YHC-A/AutoCar/report/closure/photos/prototype-back-redar-low.jpg

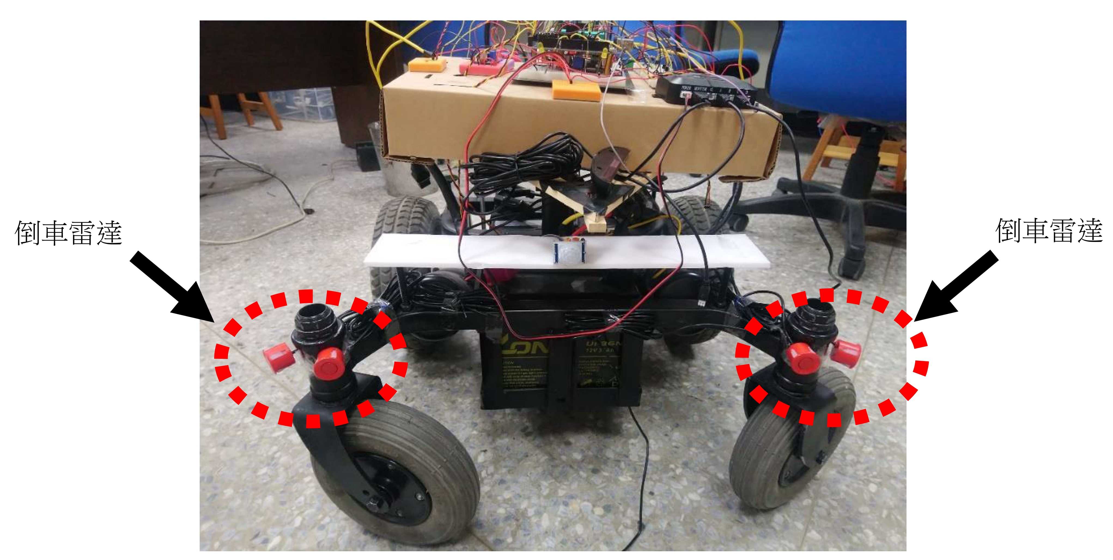
report/closure/photos/prototype-back-redar-low.jpg
