YHC-A/AutoCar/report/closure/廠商同意結案用印.jpg

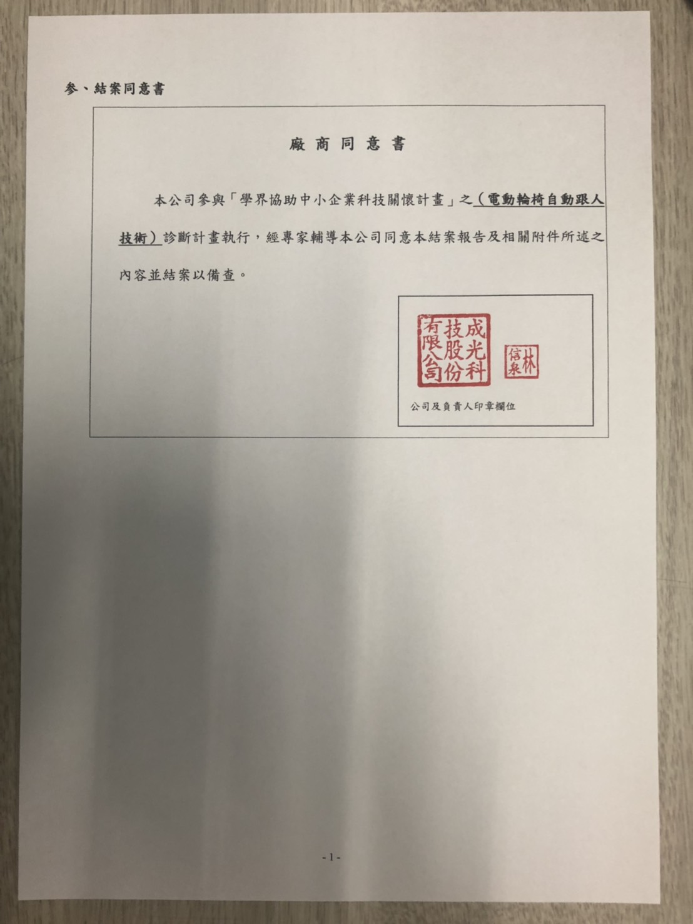
report/closure/廠商同意結案用印.jpg
