YHC-A/AutoCar/report/closure/專家簽收領據單-丁慶華.docx

專家簽收領據單

日期：107年10月8日
項次 | 計畫名稱 | 專家姓名 | 系所 | 計畫期程 | 計畫類型 | 計畫費用(千元)
1 | 電動輪椅自動跟人技術開發 | 機械與能源工程學系 | 丁慶華 | 107年05月~107年10月 | 個案計畫 | 72

專家簽名：
