YHC-A/AutoCar/report/自走車圖片/自走車圖片.docx

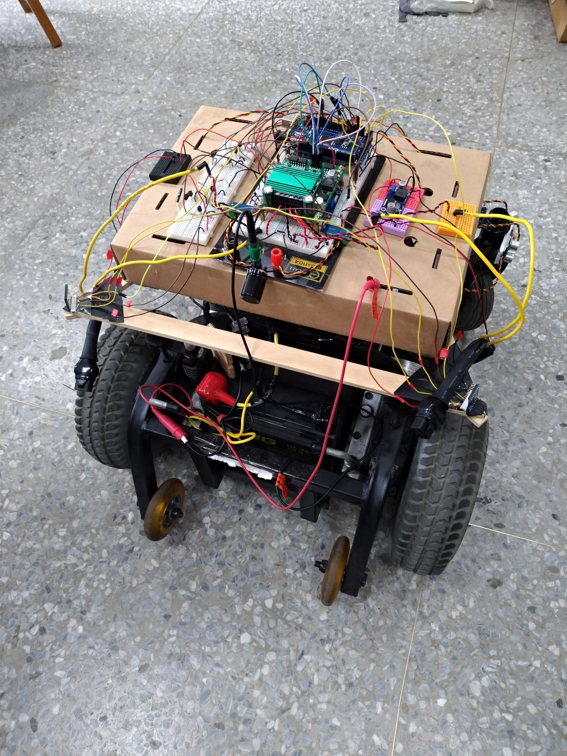
[picture p17: figure]
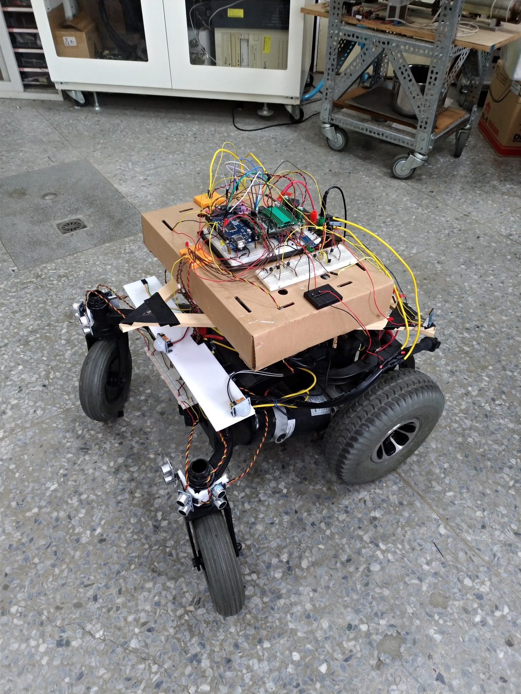
[picture p18: figure]
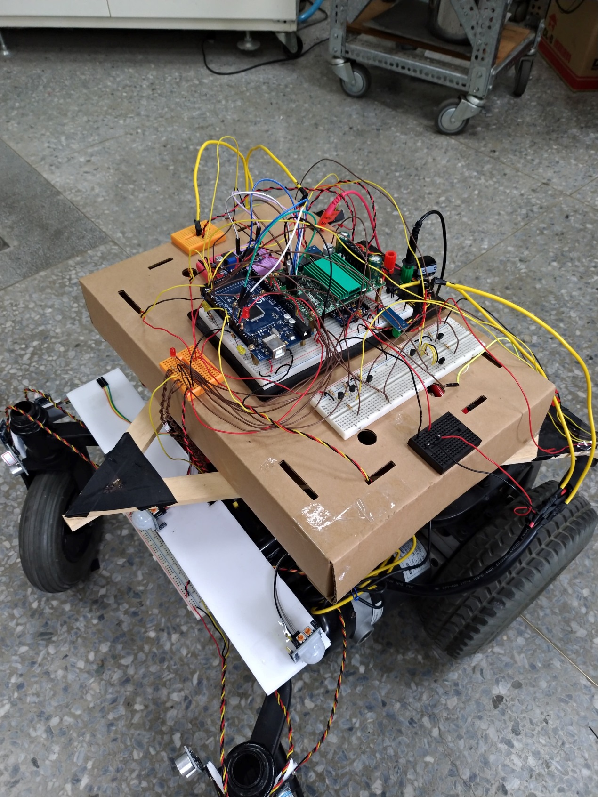
[picture p19: figure]
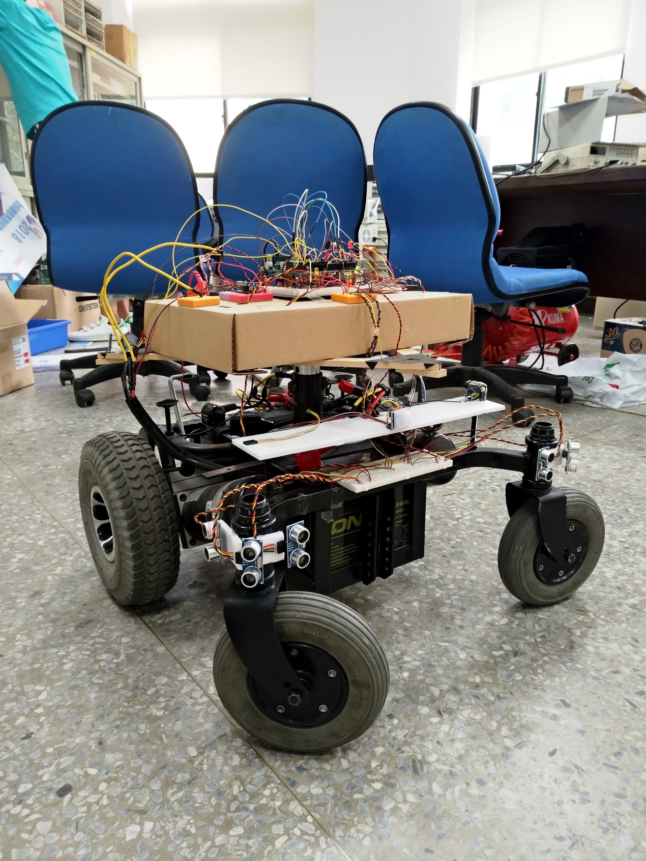
[picture p20: figure]
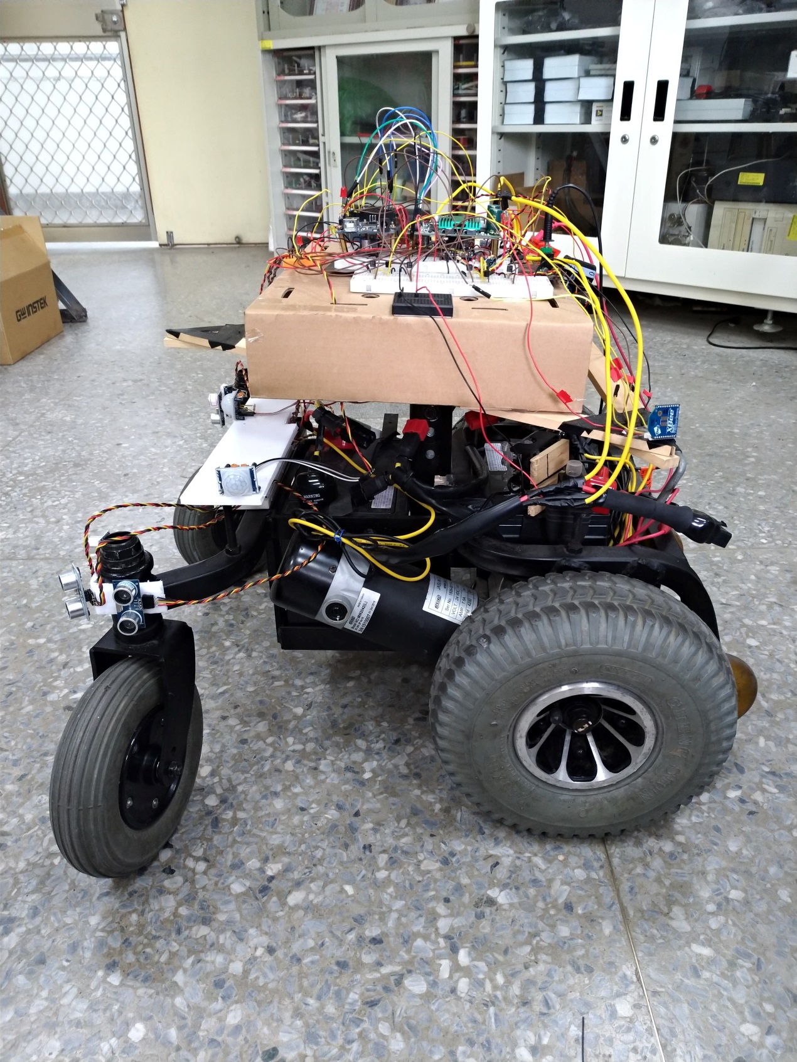
[picture p21: figure]
