YHC-A/AutoCar/report/closure/annoucement/繳交資料檢核表及經費累計表(範例).xlsx

Sheet: 繳交資料檢核表
學界關懷計畫學校繳交資料明細檢核
學校名稱：
項次 | 項目 | 已齊備打v
1 | 結案報告
2 | 經費累計表
3 | 專家簽收領據
4 | 原始支出憑證 (私立學校須寄回）
製表人：
覆 核：

Sheet: 經費累計表-空白
學界協助中小企業科技關懷跨域整合計畫
經費累計表
學校名稱：
計畫名稱：
 |  |  |  |  |  |  | 單位：新台幣元
預算數 |  |  | 累計實支數 ( D ) | 預算餘額 ( E=C-D ) | 累計已撥金額 ( F ) | 應繳回款項 | 備註
全年度預算數 ( A ) | 預算調整項目 ( B ) | 全年度預算數 ( C=A+B )
 |  | 0 |  | 0 |  | 0
製表人： |  | 覆核： |  | 主計主管： |  |  | 機關長官：
註1：預算調整項目係若有撤案等與原始預算金額有變之項目請填此處，並於備註欄位說明

Sheet: 經費累計表-例
學界協助中小企業科技關懷跨域整合計畫
經費累計表
學校名稱： | 漂亮實用大學
計畫名稱： | 咕咕鐘自動化控制技術與創新加值
 |  |  |  |  |  |  | 單位：新台幣元
預算數 |  |  | 累計實支數 ( D ) | 預算餘額 ( E=C-D ) | 累計已撥金額 ( F ) | 應繳回款項 | 備註
全年度預算數 ( A ) | 預算調整項目 ( B ) | 全年度預算數 ( C=A+B )
1272000 |  | 1272000 | 1272000 | 0 | 1272000 | 0
製表人：王大富 |  | 覆核：許大貴 |  | 主計主管： | 陳大滿 |  | 機關長官：林大堂
註1：預算調整項目係若有撤案等與原始預算金額有變之項目請填此處，並於備註欄位說明

Sheet: 經費累計表-例(有撤案)
學界協助中小企業科技關懷跨域整合計畫
經費累計表
學校名稱： | 漂亮實用大學
計畫名稱： | 咕咕鐘自動化控制技術與創新加值
 |  |  |  |  |  |  | 單位：新台幣元
預算數 |  |  | 累計實支數 ( D ) | 預算餘額 ( E=C-D ) | 累計已撥金額 ( F ) | 應繳回款項 | 備註
全年度預算數 ( A ) | 預算調整項目 ( B ) | 全年度預算數 ( C=A+B )
1272000 | -72000 | 1200000 | 1200000 | 0 | 1272000 | 72000 | 撤1個案
製表人：王大富 |  | 覆核：許大貴 |  | 主計主管： | 陳大滿 |  | 機關長官：林大堂
註1：預算調整項目係若有撤案等與原始預算金額有變之項目請填此處，並於備註欄位說明

Sheet: 經費累計表-(預算未支完)
學界協助中小企業科技關懷跨域整合計畫
經費累計表
學校名稱： | 漂亮實用大學
計畫名稱： | 咕咕鐘自動化控制技術與創新加值
 |  |  |  |  |  |  | 單位：新台幣元
預算數 |  |  | 累計實支數 ( D ) | 預算餘額 ( E=C-D ) | 累計已撥金額 ( F ) | 應繳回款項 | 備註
全年度預算數 ( A ) | 預算調整項目 ( B ) | 全年度預算數 ( C=A+B )
1272000 |  | 1272000 | 1100000 | 172000 | 1272000 | 172000
製表人：王大富 |  | 覆核：許大貴 |  | 主計主管： | 陳大滿 |  | 機關長官：林大堂
註1：預算調整項目係若有撤案等與原始預算金額有變之項目請填此處，並於備註欄位說明
