YHC-A/AutoCar/report/2018-08-17-S__95945035.jpg

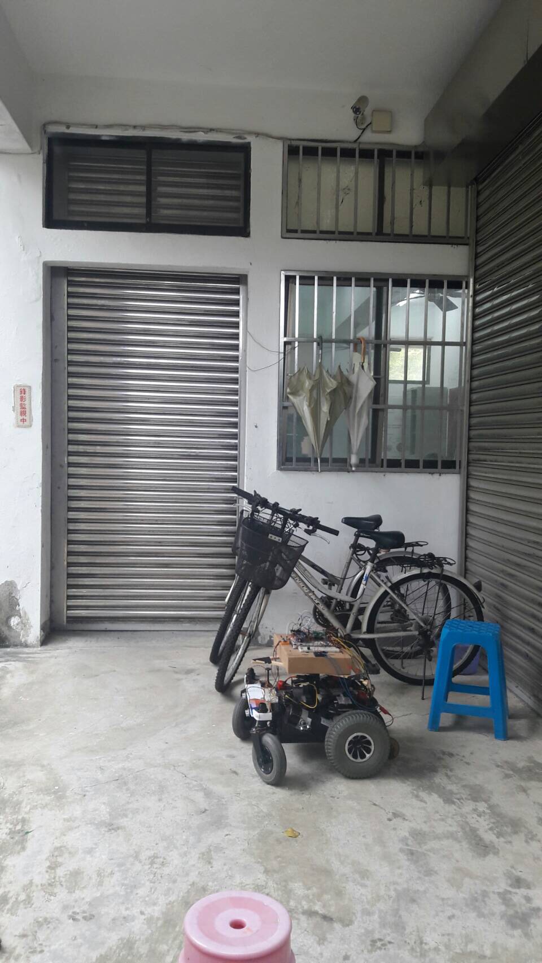
report/2018-08-17-S__95945035.jpg
