YHC-A/AutoCar/report/closure/photos/flow-chart.jpg

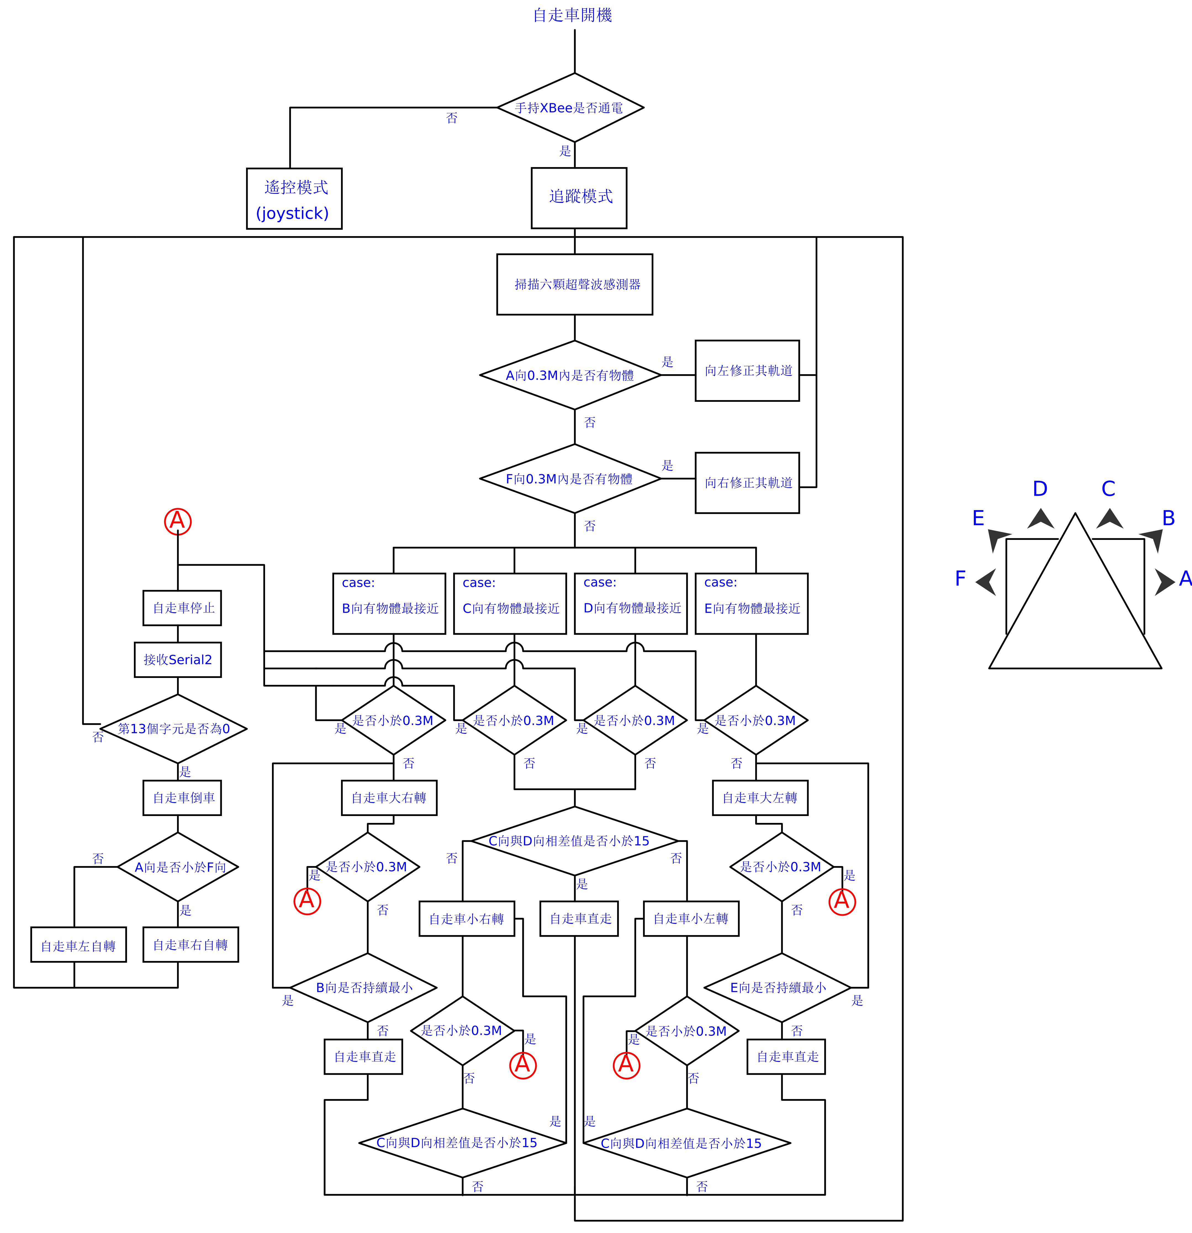
report/closure/photos/flow-chart.jpg
