YHC-A/AutoCar/report/closure/photos/system-architecture.jpg

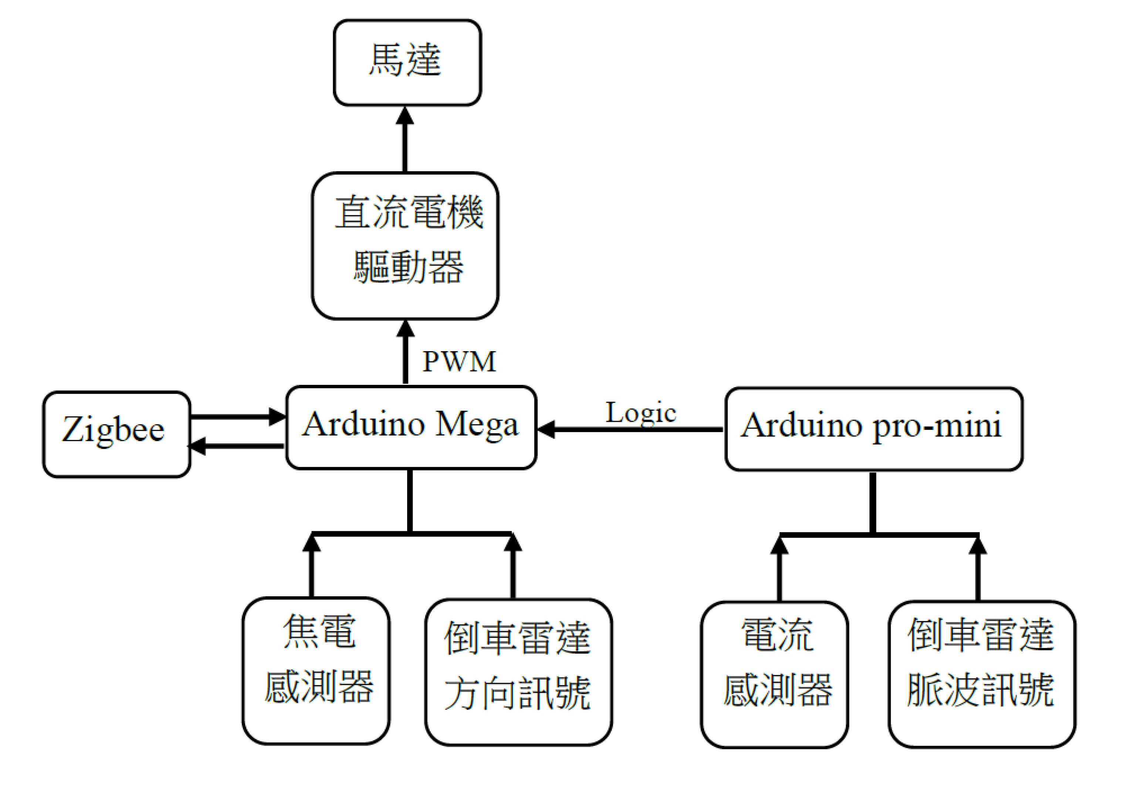
report/closure/photos/system-architecture.jpg
