YHC-A/AutoCar/report/控制器切換電路/繼電器切換.png

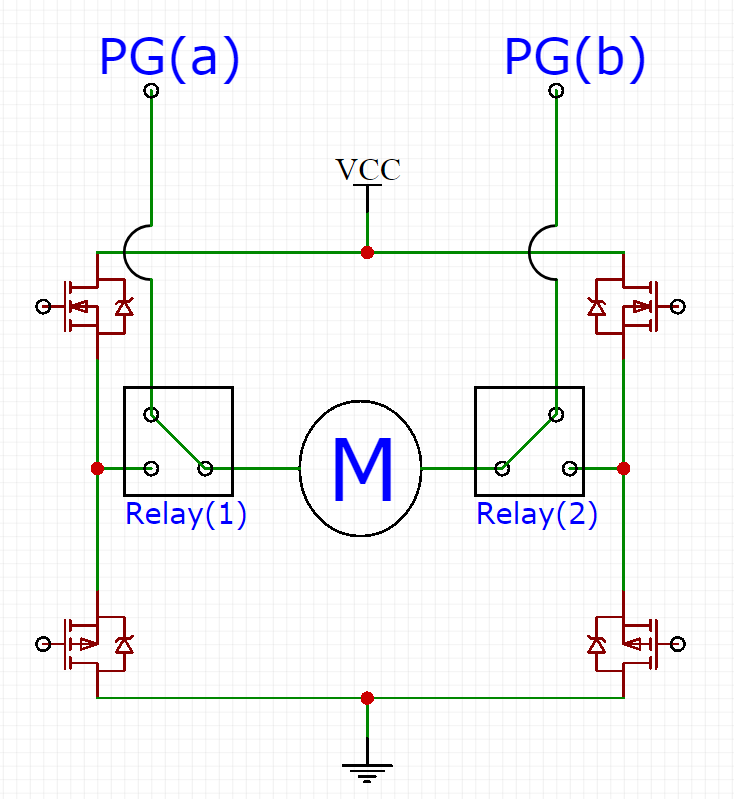
report/控制器切換電路/繼電器切換.png
