YHC-A/AutoCar/report/黃思豪/硬體線路.jpg

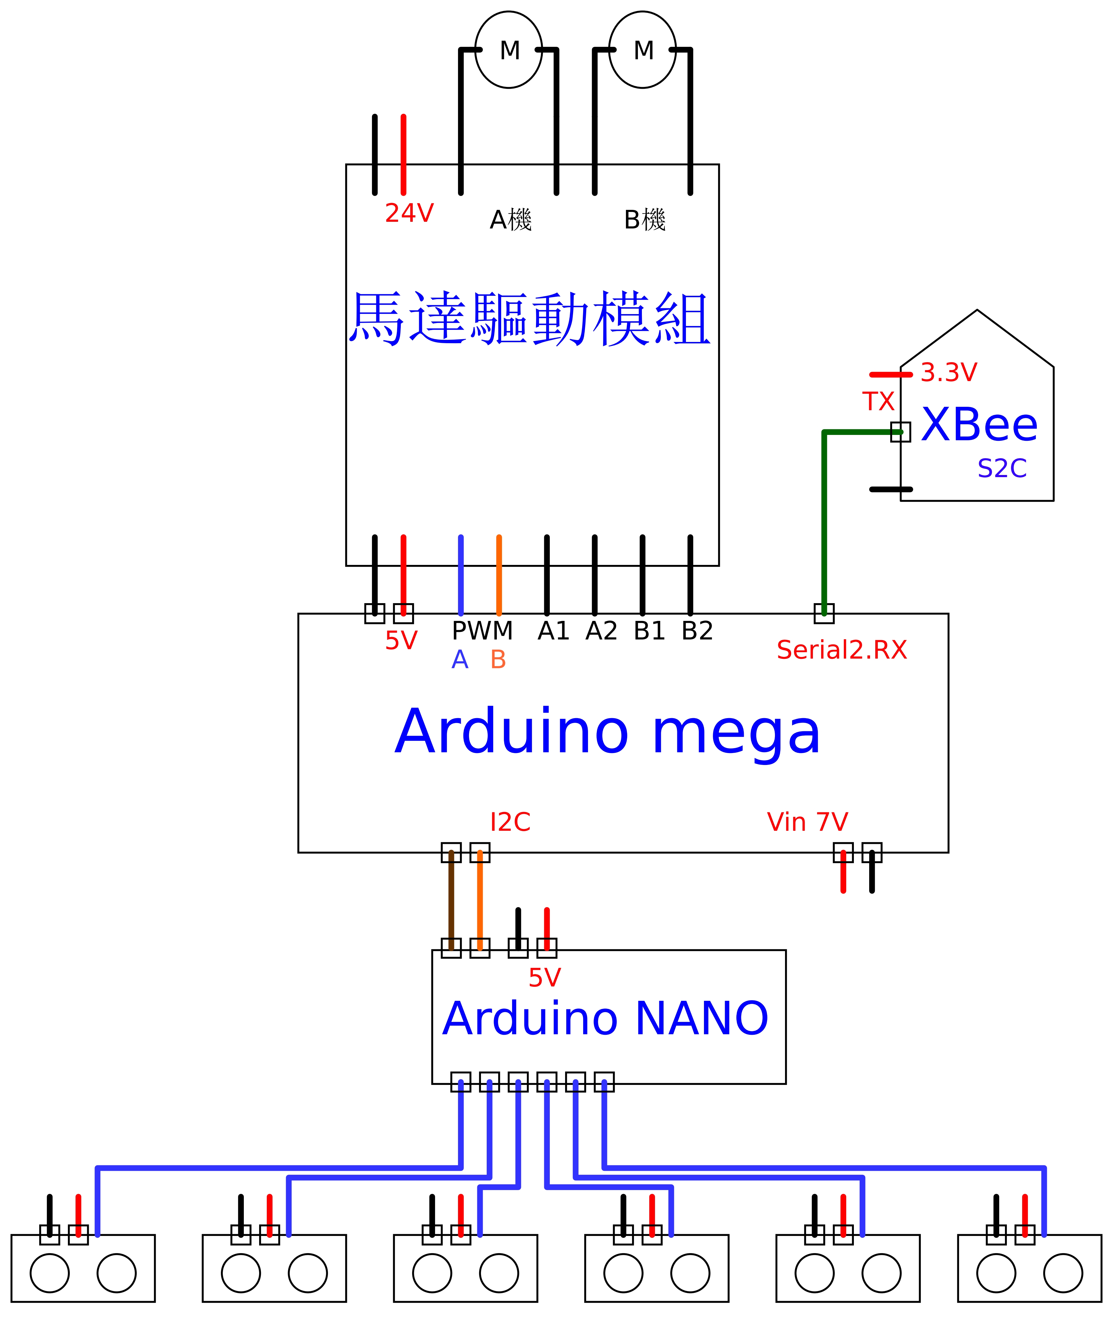
report/黃思豪/硬體線路.jpg
