YHC-A/AutoCar/report/黃思豪/紅外線.bmp

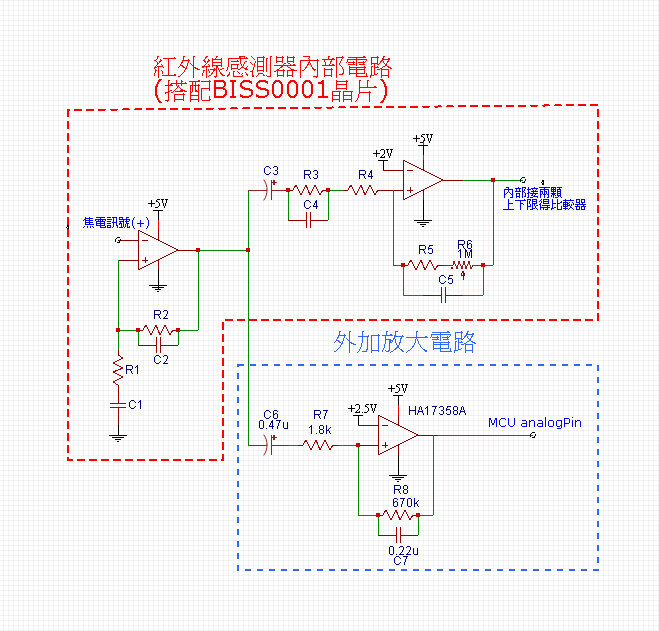
report/黃思豪/紅外線.bmp
