YHC-A/AutoCar/report/黃思豪/繼電器.bmp

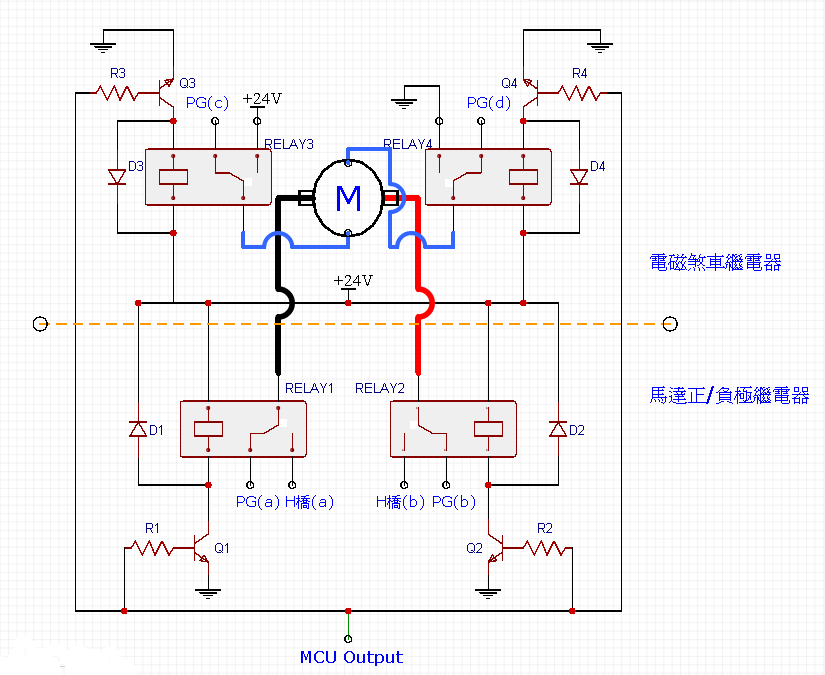
report/黃思豪/繼電器.bmp
