YHC-A/AutoCar/2018-01-成光-Zigbee追蹤/purchase/ID-back.jpg

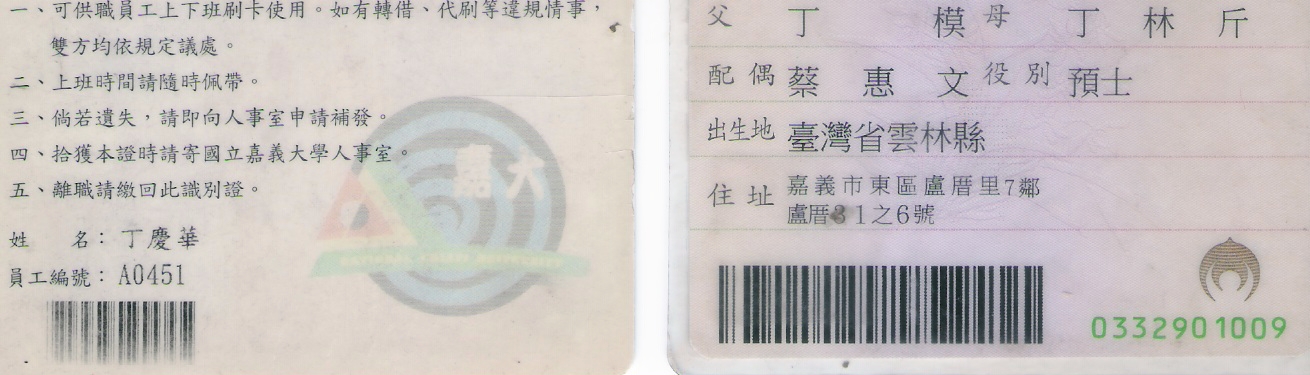
2018-01-成光-Zigbee追蹤/purchase/ID-back.jpg
