YHC-A/AutoCar/2018-01-成光-Zigbee追蹤/purchase/ID-front.jpg

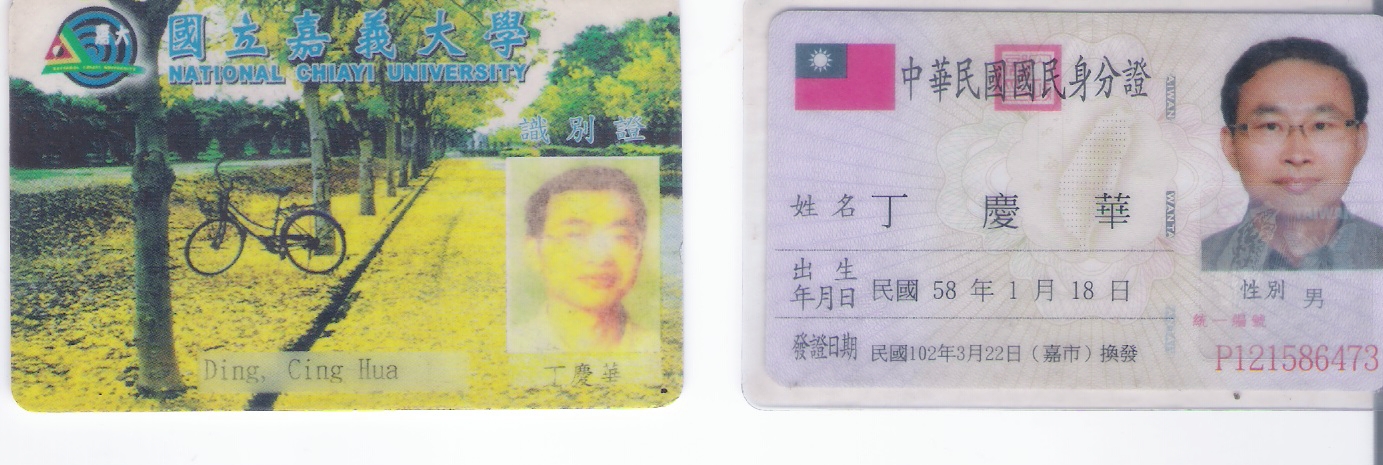
2018-01-成光-Zigbee追蹤/purchase/ID-front.jpg
