YHC-A/AutoCar/2018-01-成光-Zigbee追蹤/purchase/委任書.jpg

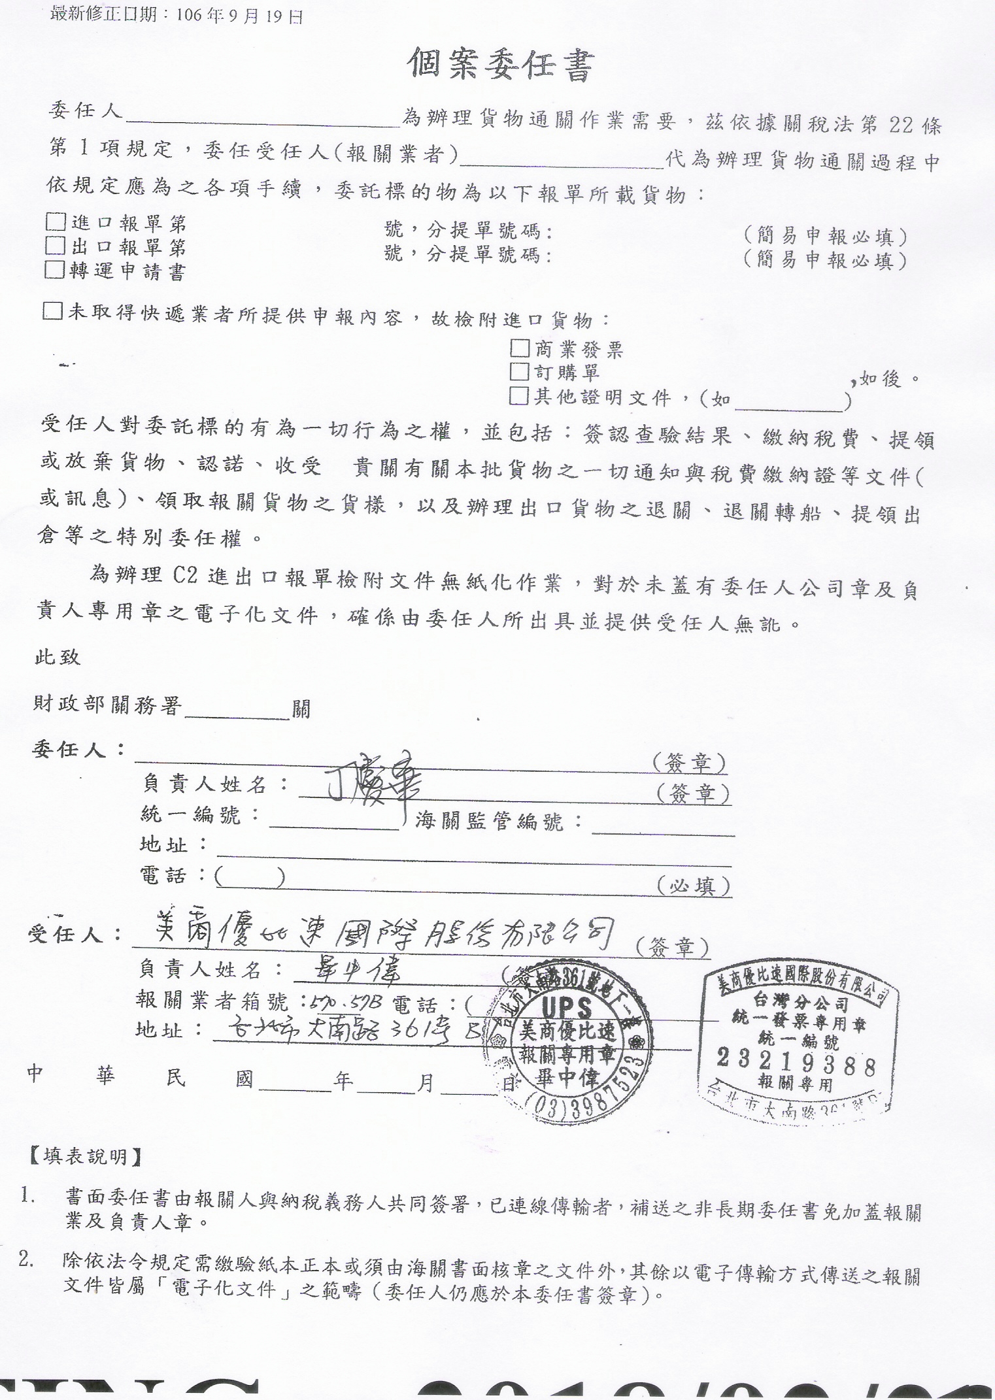
2018-01-成光-Zigbee追蹤/purchase/委任書.jpg
