YHC-A/AutoCar/report/黃思豪/硬體線路.pdf

# 馬達驅動模組

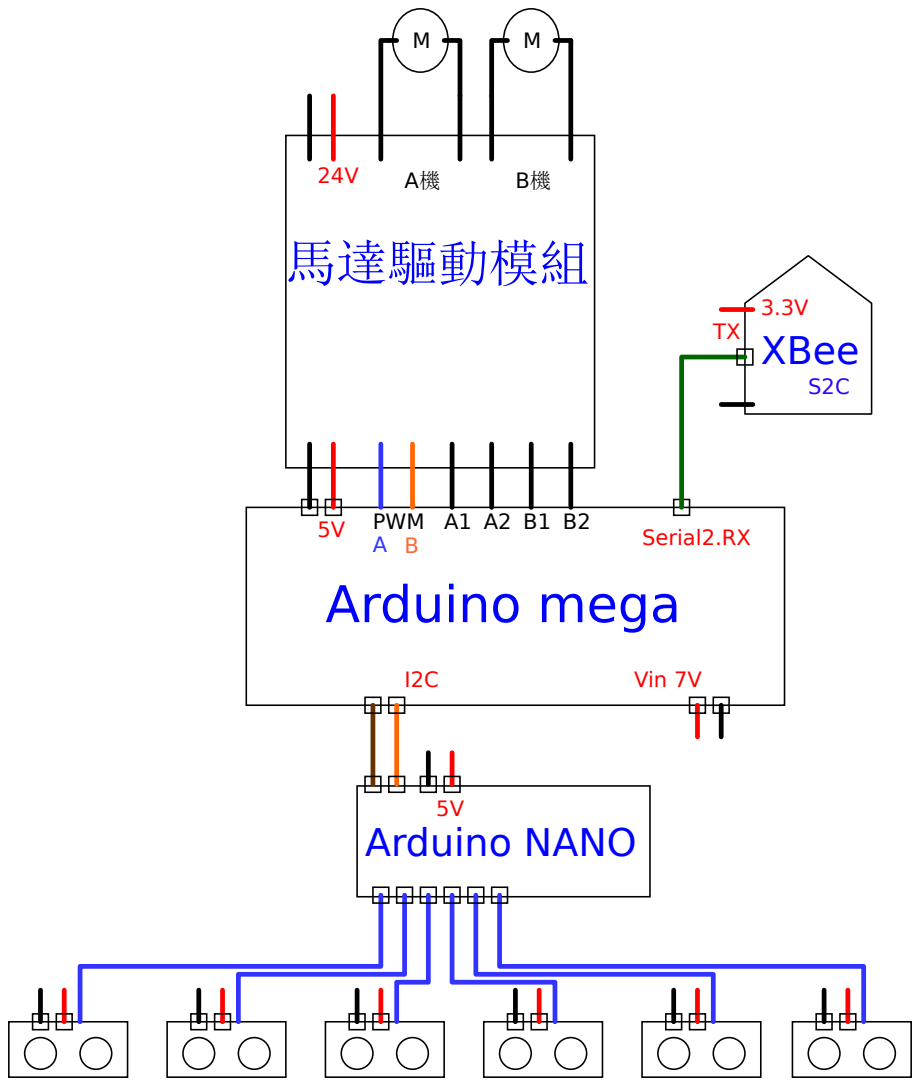
[picture p32: page 1]
Arduino mega; Arduino NANO; XBee; Serial2.RX; PWM A B; Vin 7V
